SaltedFishSang/The-code-of-smart-electricity-meter/软件代码/单相4P带屏/4G/新协议/协议Json字段.png

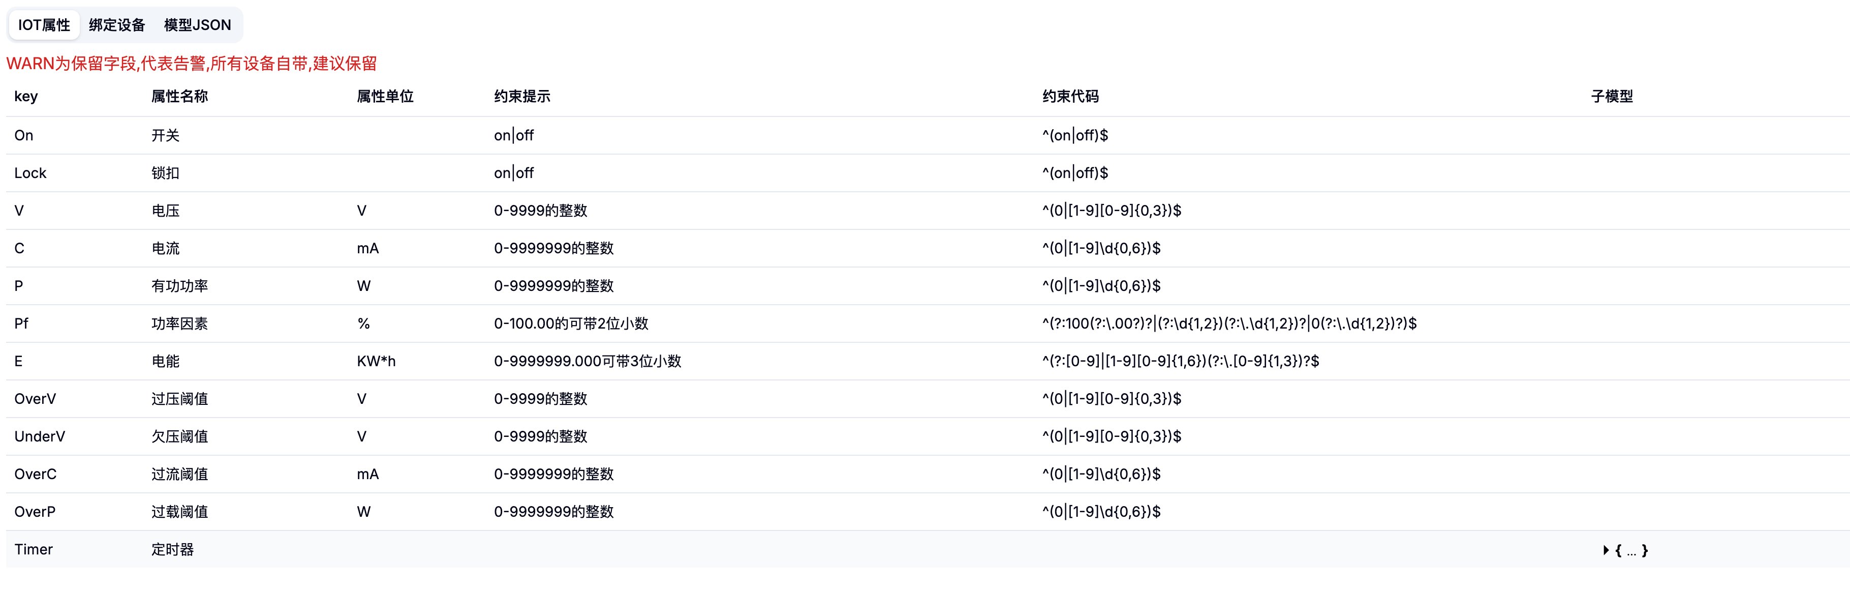
软件代码/单相4P带屏/4G/新协议/协议Json字段.png
