SaltedFishSang/The-code-of-smart-electricity-meter/电路图/单相4P电表/4G模块/4G模块BOM.xlsx

类型 | 类别 | 名称 | 规格 | 封装 | 电路板上标记 | 数量
 | 电阻类 | 贴片电阻 | 40.2K/1% | R0603 | R3 | 1
 |  | 贴片电阻 | 10K/1% | R0603 | R4 | 1
 |  | 贴片电阻 | 1K/5% | R0603 | R1，R21,R22,R27，R28 | 5
 |  | 贴片电阻 | 10K/5% | R0603 | R17,R19，R12，R2 | 4
 |  | 贴片电阻 | 4.7K/5% | R0603 | R16,R18,R23,R24,R7,R10 | 6
 |  | 贴片电阻 | 47K/5% | R0603 | R25,R26,R11 | 3
 |  | 贴片电阻 | 0R/5% | R0603 | R20，R14，R15，R5，R13 | 5
 | 电容类 | 贴片陶瓷电容 | 47uF/25V | C0805 | C3,C5 | 2
 |  | 贴片陶瓷电容 | 10uF/25V | C0805 | C2,C4 | 2
 |  | 贴片陶瓷电容 | 0.1uF/25V | C0603 | C1,C6,C15，C22 | 4
 |  | 贴片陶瓷电容 | 1nF/10V | C0603 | C26,C27 | 2
 |  | 贴片陶瓷电容 | 10pF/10V | C0603 | C13 | 1
 |  | 贴片陶瓷电容 | 33pF/10V | C0603 | C14，C24，C25，C23 | 4
 |  | 贴片陶瓷电容 | 100uF/10V | C1210 | C12 | 1
 |  | 贴片陶瓷电容 | 10nF/10V | C0603 | C21 | 1
 | 二极管类 | 贴片发光二极管 | 蓝色 | LED0805 | LED1，LED2，LED3，LED4,LED5, | 5
电容类
 | 三极管类 | 贴片三极管 | S8050 | SOT-23 | Q2,Q3，Q4，Q5，Q6 | 5
 | IC芯片 | 电源芯片 | DIO6920TST6 | SOT-23-6DBV | U1 | 1
 |  | 4G模组 | ML307A-DCLN |  | U2 | 1
 |  | 贴片天线座子 | 一代贴片天线座子 | U.FL-R-SMT | S1 | 1
 |  | SIM卡卡座 | SMN-303 |  | CARD1 | 1
 |  | IC芯片 | SMF05C | SC70-6L | U3 | 1
 | 电感 | 贴片电感 | 4.7UH/2.5A | WNR5020 | L1 | 1
 | 接插件类 | 2.54MM间距单排针 | 2.54MM间距 1*8P 针长7.5MM |  | P1 | 1
保险丝类
二极管类
三极管MOS管类
IC芯片类
晶振类
接插件
