SaltedFishSang/The-code-of-smart-electricity-meter/(list of files, cad)

Other CAD files:
0.96焊接屏幕/03-程序源码(1)/03-程序源码/IIC接口显示屏例程/51例程/01-0.96OLED显示屏C51_IIC例程/main.OBJ
0.96焊接屏幕/03-程序源码(1)/03-程序源码/IIC接口显示屏例程/51例程/01-0.96OLED显示屏C51_IIC例程/oled.obj
电路图/单相4P电表/4p3X结构图.DWG
0.96焊接屏幕/03-程序源码(1)/03-程序源码/IIC接口显示屏例程/51例程/01-0.96OLED显示屏C51_IIC例程/STARTUP.OBJ
