SaltedFishSang/The-code-of-smart-electricity-meter/电路图/单相4P电表/4G模块/4G_Module.pdf

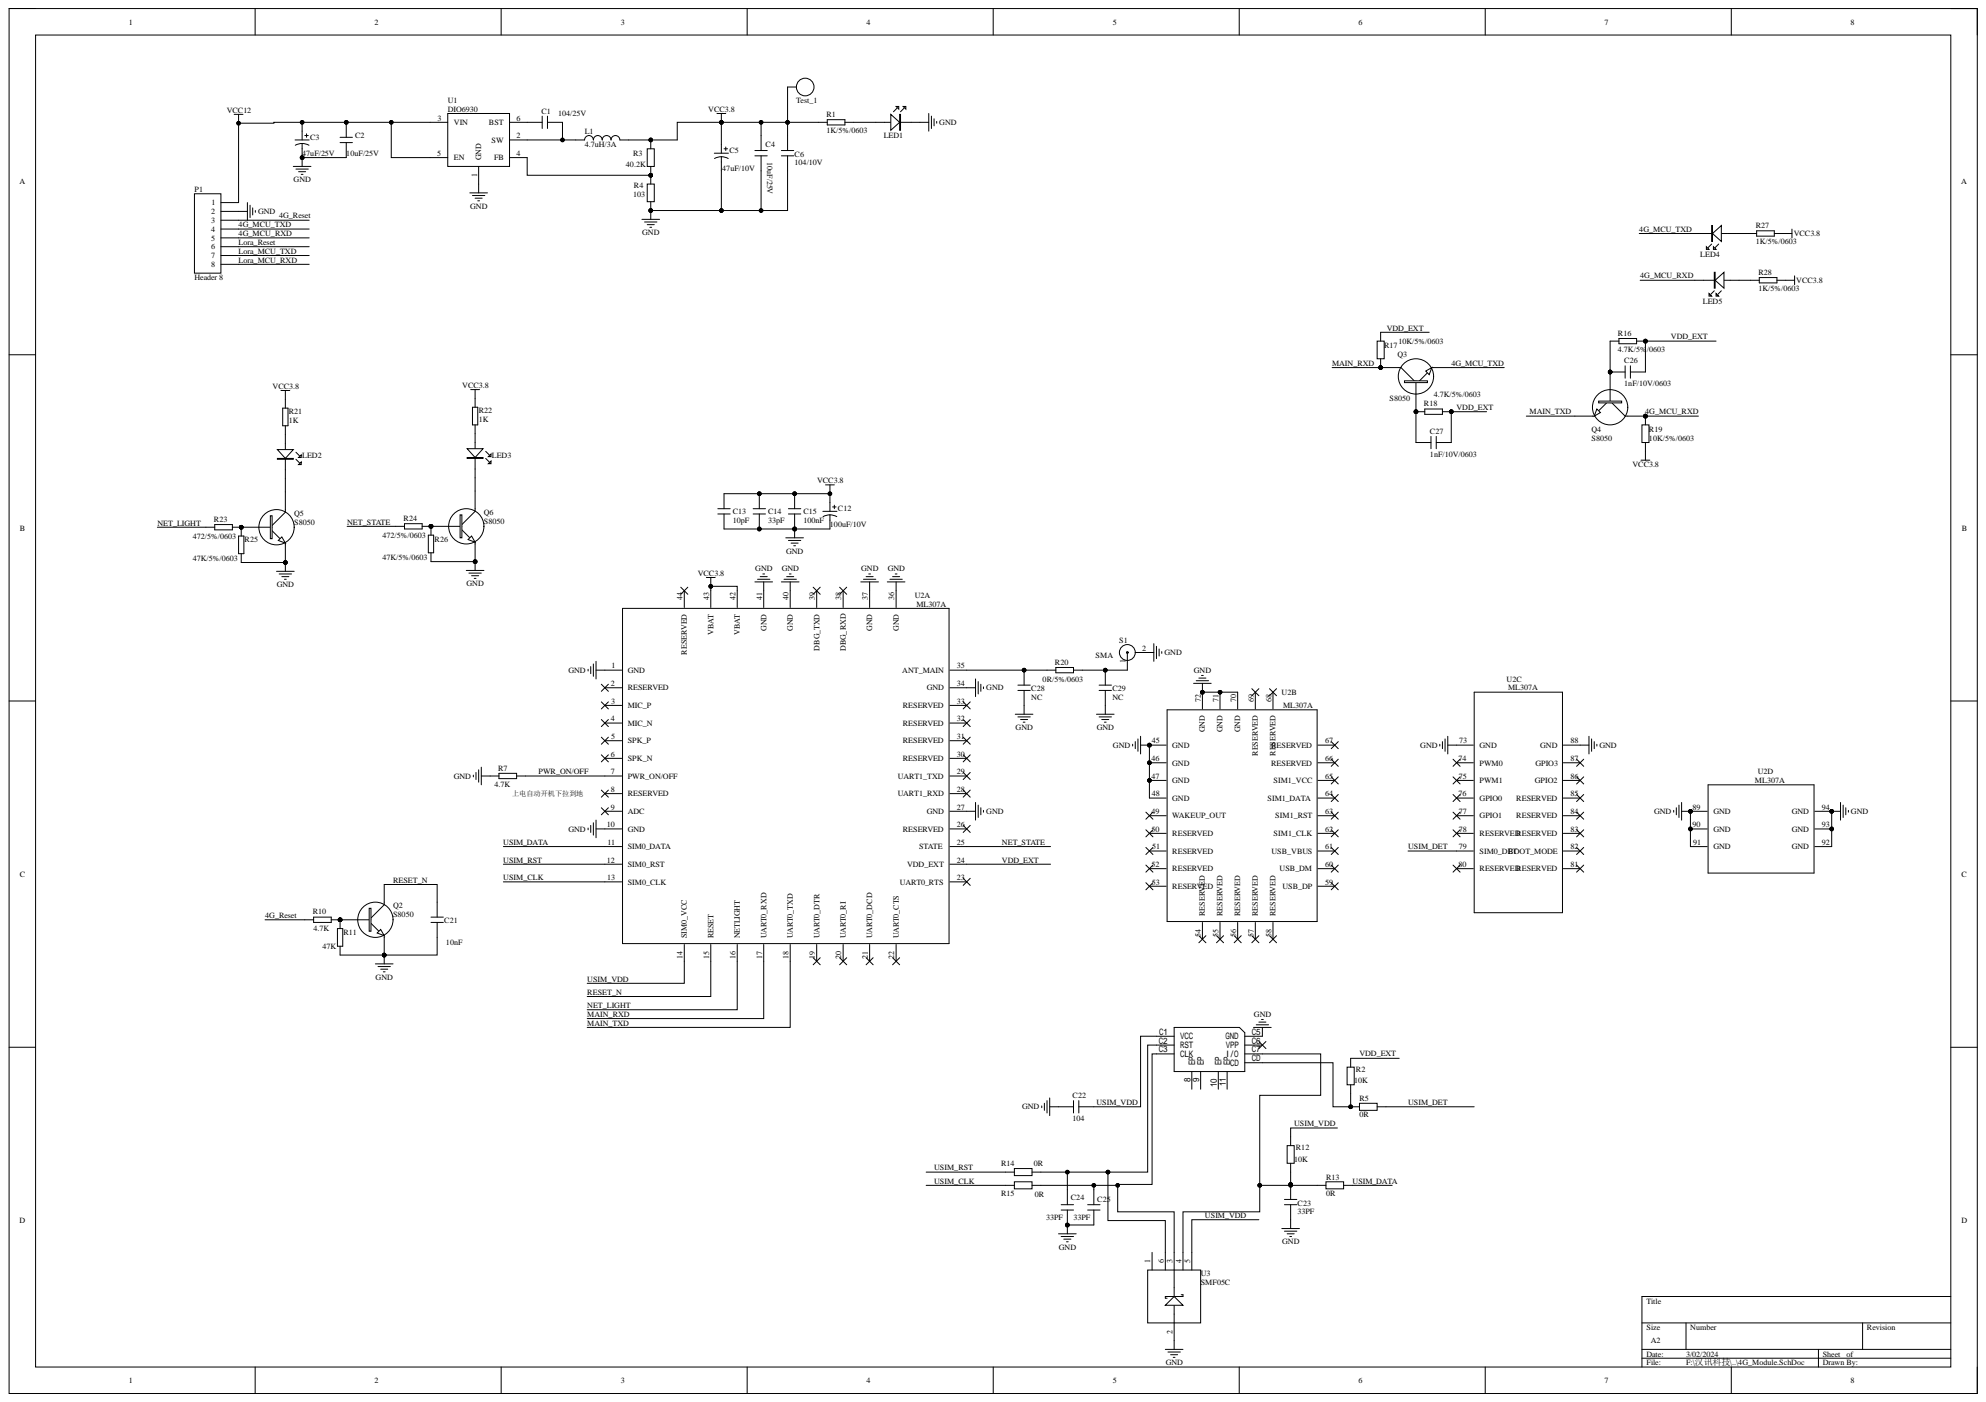
[picture p17: page 1]

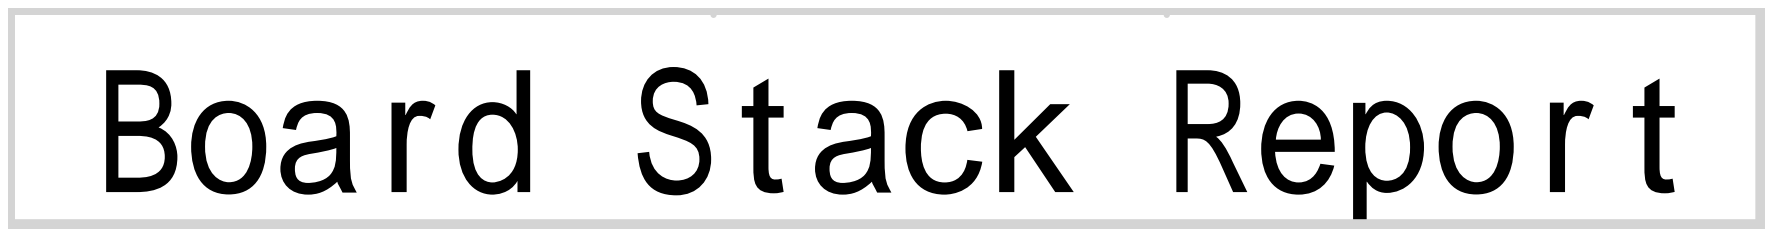
[picture p18: page 2]
