SaltedFishSang/The-code-of-smart-electricity-meter/电路图/单相4P电表/4G模块/Power.pdf

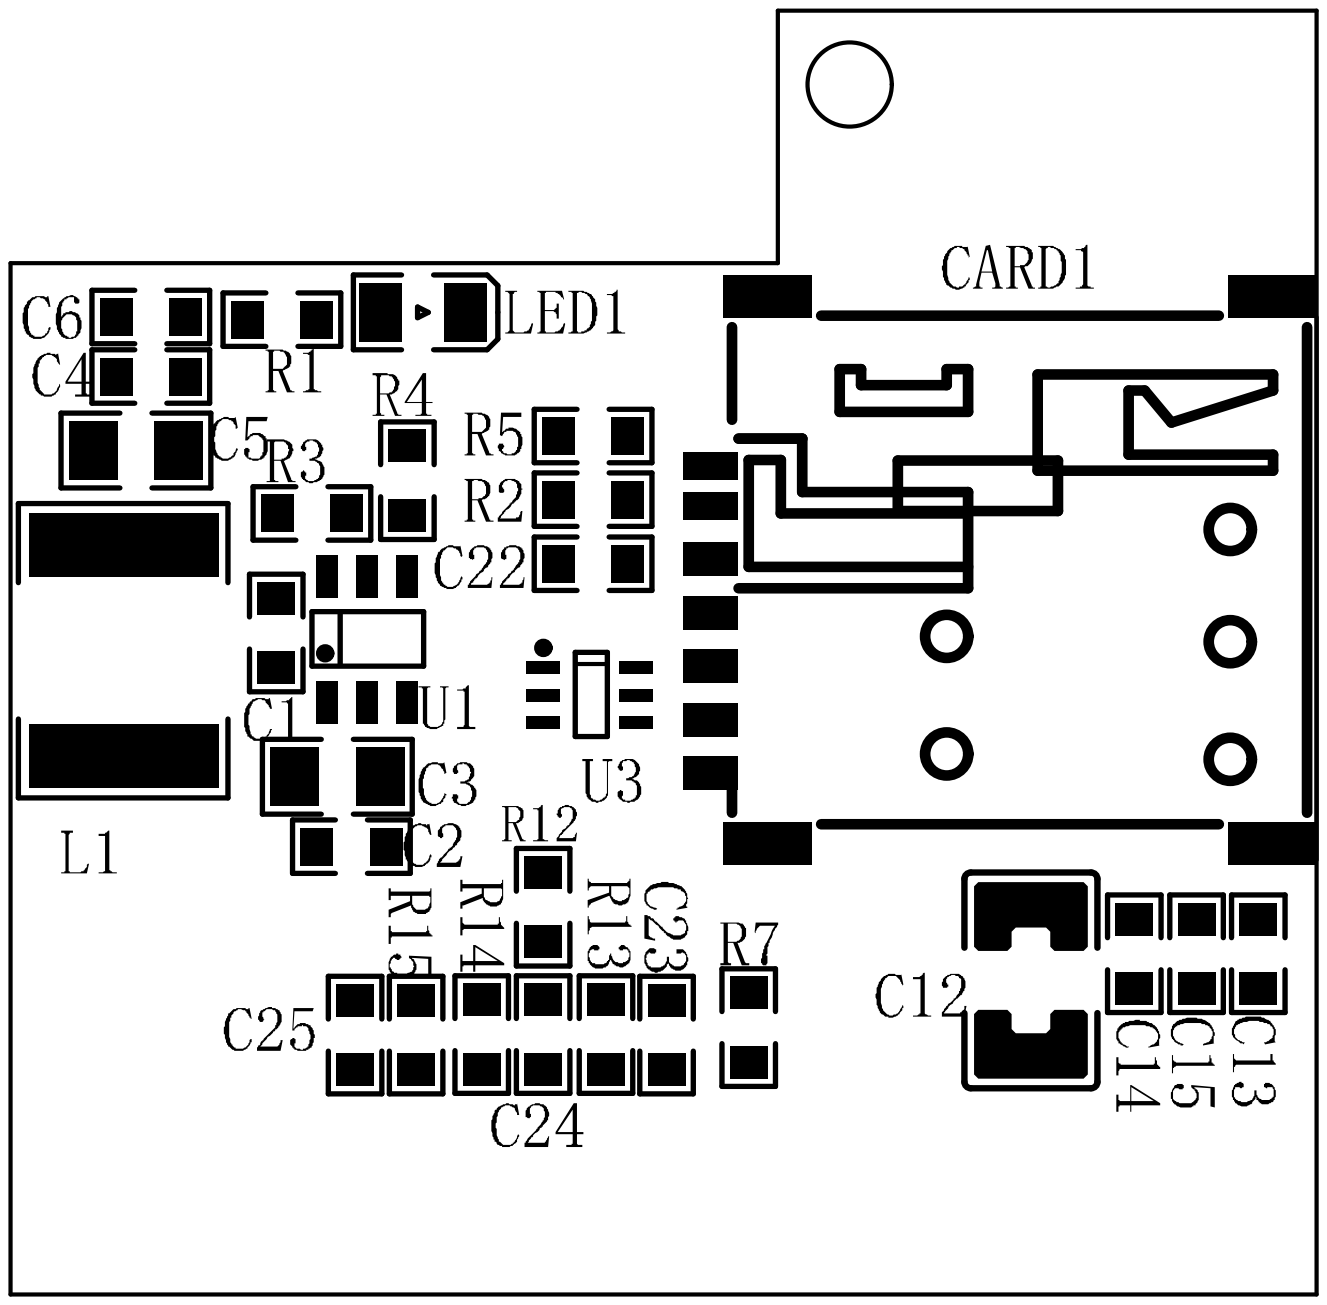
[picture p19: page 1]
