SaltedFishSang/The-code-of-smart-electricity-meter/(list of files, drawings)

Other design files:
电路图/wifi 模组/wifi模块 - 副本/4G_Module.SchDoc
电路图/wifi 模组/wifi模块 - 副本/BY-IOM-v0.2.PrjPCB
电路图/wifi 模组/wifi模块 - 副本/Power.PcbDoc
电路图/wifi 模组/wifi模块 - 副本/Wifi.SchDoc
电路图/wifi 模组/wifi模块/4G_Module.SchDoc
电路图/wifi 模组/wifi模块/BY-IOM-v0.2.PrjPCB
电路图/wifi 模组/wifi模块/Power.PcbDoc
电路图/wifi 模组/wifi模块/Wifi.SchDoc
电路图/单相2P电表/上板 - (带蓝牙)/显示.SchDoc
电路图/单相2P电表/低配底板/Power.PcbDoc
电路图/单相2P电表/高配上板 - 副本 - 副本/Altium designer 器件库230226/Sangjian_Pcb.PcbLib
电路图/单相2P电表/高配上板 - 副本 - 副本/BY-IOM-v0.2.PrjPCB
电路图/单相2P电表/高配上板 - 副本 - 副本/ES_Pcb.PcbLib
电路图/单相2P电表/高配上板 - 副本 - 副本/ES_Pcb_x.PcbLib
电路图/单相2P电表/高配上板 - 副本 - 副本/MCU.SchDoc
电路图/单相2P电表/高配上板 - 副本 - 副本/Nuc977-Board.PcbLib
电路图/单相2P电表/高配上板 - 副本 - 副本/OLED0.96.SchDoc
电路图/单相2P电表/高配上板 - 副本 - 副本/Power.PcbDoc
电路图/单相2P电表/高配上板 - 副本 - 副本/Power.SchDoc
电路图/单相2P电表/高配上板 - 副本 - 副本/Sheet1.SchDoc
电路图/单相2P电表/高配上板 - 副本 - 副本/继电器.SchDoc
电路图/单相2P电表/高配上板 - 副本 - 副本/连接.SchDoc
电路图/单相2P电表/高配上板 - 副本/Power.PcbDoc
电路图/单相2P电表/高配底板 - 4G/4G.SchDoc
电路图/单相2P电表/高配底板 - 4G/Altium designer 器件库230226/Sangjian_Pcb.PcbLib
电路图/单相2P电表/高配底板 - 4G/BY-IOM-v0.2.PrjPCB
电路图/单相2P电表/高配底板 - 4G/ES_Pcb.PcbLib
电路图/单相2P电表/高配底板 - 4G/ES_Pcb_x.PcbLib
电路图/单相2P电表/高配底板 - 4G/Nuc977-Board.PcbLib
电路图/单相2P电表/高配底板 - 4G/Power.PcbDoc
电路图/单相2P电表/高配底板 - 4G/Power.SchDoc
电路图/单相2P电表/高配底板 - 4G/Sheet1.SchDoc
电路图/单相2P电表/高配底板 - 4G/漏电流检测.SchDoc
电路图/单相2P电表/高配底板 - 4G/继电器.SchDoc
电路图/单相2P电表/高配底板 - 4G/计量.SchDoc
电路图/单相2P电表/高配底板 - 4G/连接.SchDoc
电路图/单相2P电表/高配底板--4G_WiFi_BT/Altium designer 器件库230226/Sangjian_Pcb.PcbLib
电路图/单相2P电表/高配底板--4G_WiFi_BT/BY-IOM-v0.2.PrjPCB
电路图/单相2P电表/高配底板--4G_WiFi_BT/ES_Pcb.PcbLib
电路图/单相2P电表/高配底板--4G_WiFi_BT/ES_Pcb_x.PcbLib
电路图/单相2P电表/高配底板--4G_WiFi_BT/Nuc977-Board.PcbLib
电路图/单相2P电表/高配底板--4G_WiFi_BT/Power.PcbDoc
电路图/单相2P电表/高配底板--4G_WiFi_BT/Power.SchDoc
电路图/单相2P电表/高配底板--4G_WiFi_BT/Sheet1.SchDoc
电路图/单相2P电表/高配底板--4G_WiFi_BT/继电器.SchDoc
电路图/单相2P电表/高配底板--4G_WiFi_BT/计量.SchDoc
电路图/单相2P电表/高配底板--4G_WiFi_BT/连接.SchDoc
电路图/单相4P电表/4G模块/4G_Module.SchDoc
电路图/单相4P电表/4G模块/BY-IOM-v0.2.PrjPCB
电路图/单相4P电表/上板 - 副本/Power.PcbDoc
电路图/单相4P电表/底板 - 副本/Altium designer 器件库230226/Sangjian_Pcb.PcbLib
电路图/单相4P电表/底板 - 副本/BY-IOM-v0.2.PrjPCB
电路图/单相4P电表/底板 - 副本/ES_Pcb.PcbLib
电路图/单相4P电表/底板 - 副本/ES_Pcb_x.PcbLib
电路图/单相4P电表/底板 - 副本/Nuc977-Board.PcbLib
电路图/单相4P电表/底板 - 副本/Power.PcbDoc
电路图/单相4P电表/底板 - 副本/Power.SchDoc
电路图/单相4P电表/底板 - 副本/RS485.SchDoc
电路图/单相4P电表/底板 - 副本/Sheet1.SchDoc
电路图/单相4P电表/底板 - 副本/漏电流检测.SchDoc
电路图/单相4P电表/底板 - 副本/继电器.SchDoc
电路图/单相4P电表/底板 - 副本/计量.SchDoc
电路图/单相4P电表/底板 - 副本/连接.SchDoc
