SaltedFishSang/The-code-of-smart-electricity-meter/软件代码/单相2P不带屏幕/20260105/N32WB03/N32WB03x_SDK_V1.3.3/projects/n32wb03x_EVAL/peripheral/USART/Printf/src/main.c

/*****************************************************************************
 * Copyright (c) 2019, Nations Technologies Inc.
 *
 * All rights reserved.
 * ****************************************************************************
 *
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
 * Nations' name may not be used to endorse or promote products derived from
 * this software without specific prior written permission.
 *
 * DISCLAIMER: THIS SOFTWARE IS PROVIDED BY NATIONS "AS IS" AND ANY EXPRESS OR
 * IMPLIED WARRANTIES, INCLUDING, BUT NOT LIMITED TO, THE IMPLIED WARRANTIES OF
 * MERCHANTABILITY, FITNESS FOR A PARTICULAR PURPOSE AND NON-INFRINGEMENT ARE
 * DISCLAIMED. IN NO EVENT SHALL NATIONS BE LIABLE FOR ANY DIRECT, INDIRECT,
 * INCIDENTAL, SPECIAL, EXEMPLARY, OR CONSEQUENTIAL DAMAGES (INCLUDING, BUT NOT
 * LIMITED TO, PROCUREMENT OF SUBSTITUTE GOODS OR SERVICES; LOSS OF USE, DATA,
 * OR PROFITS; OR BUSINESS INTERRUPTION) HOWEVER CAUSED AND ON ANY THEORY OF
 * LIABILITY, WHETHER IN CONTRACT, STRICT LIABILITY, OR TORT (INCLUDING
 * NEGLIGENCE OR OTHERWISE) ARISING IN ANY WAY OUT OF THE USE OF THIS SOFTWARE,
 * EVEN IF ADVISED OF THE POSSIBILITY OF SUCH DAMAGE.
 * ****************************************************************************/

/**
 * @file main.c
 * @author Nations Firmware Team
 * @version v1.0.0
 *
 * @copyright Copyright (c) 2019, Nations Technologies Inc. All rights reserved.
 */
#include <stdio.h>
#include "main.h"

/** @addtogroup N32WB03X_StdPeriph_Examples
 * @{
 */

/** @addtogroup USART_Printf
 * @{
 */

USART_InitType USART_InitStructure;

/**
 * @brief  Main program
 */
int main(void)
{
    RCC_ClocksType RCC_ClocksStatus;
    
    /* System Clocks Configuration */
    RCC_Configuration();

    /* Configure the GPIO ports */
    GPIO_Configuration();

    RCC_GetClocksFreqValue(&RCC_ClocksStatus);

    /* USARTy and USARTz configuration ------------------------------------------------------*/
    USART_InitStructure.BaudRate            = 115200;
    USART_InitStructure.WordLength          = USART_WL_8B;
    USART_InitStructure.StopBits            = USART_STPB_1;
    USART_InitStructure.Parity              = USART_PE_NO;
    USART_InitStructure.HardwareFlowControl = USART_HFCTRL_NONE;
    USART_InitStructure.Mode                = USART_MODE_RX | USART_MODE_TX;

    /* Configure USARTx */
    USART_Init(USARTx, &USART_InitStructure);
    /* Enable the USARTx */
    USART_Enable(USARTx, ENABLE);

    /* Output a message on Hyperterminal using printf function */
    printf("\n\rUSART Printf Example: retarget the C library printf function to the USART\n\r");

    while (1)
    {
			printf("1111\r\n");
    }
}

/**
 * @brief  Configures the different system clocks.
 */
void RCC_Configuration(void)
{
    /* Enable GPIO clock */
    GPIO_APBxClkCmd(USARTx_GPIO_CLK, ENABLE);
    /* Enable USARTx Clock */
    USART_APBxClkCmd(USARTx_CLK, ENABLE);
}

/**
 * @brief  Configures the different GPIO ports.
 */
void GPIO_Configuration(void)
{
    GPIO_InitType GPIO_InitStructure;

    /* Initialize GPIO_InitStructure */
    GPIO_InitStruct(&GPIO_InitStructure);    

    /* Configure USARTx Tx as alternate function push-pull */
    GPIO_InitStructure.Pin            = USARTx_TxPin;
    GPIO_InitStructure.GPIO_Mode      = GPIO_MODE_AF_PP;
    GPIO_InitStructure.GPIO_Alternate = USARTx_Tx_GPIO_AF;
    GPIO_InitPeripheral(USARTx_GPIO, &GPIO_InitStructure);   

    /* Configure USARTx Rx as alternate function push-pull */
    GPIO_InitStructure.Pin            = USARTx_RxPin;
    GPIO_InitStructure.GPIO_Alternate = USARTx_Rx_GPIO_AF;
    GPIO_InitPeripheral(USARTx_GPIO, &GPIO_InitStructure); 
}

/* retarget the C library printf function to the USART */
int fputc(int ch, FILE* f)
{
    USART_SendData(USARTx, (uint8_t)ch);
    while (USART_GetFlagStatus(USARTx, USART_FLAG_TXDE) == RESET);

    return (ch);
}

#ifdef USE_FULL_ASSERT

/**
 * @brief  Reports the name of the source file and the source line number
 *         where the assert_param error has occurred.
 * @param file pointer to the source file name
 * @param line assert_param error line source number
 */
void assert_failed(const uint8_t* expr, const uint8_t* file, uint32_t line)
{
    /* User can add his own implementation to report the file name and line number,
       ex: printf("Wrong parameters value: file %s on line %d\r\n", file, line) */

    /* Infinite loop */
    while (1)
    {
    }
}

#endif

/**
 * @}
 */

/**
 * @}
 */
